hypothete/shiny-machine/example_secrets.h

// SECRET - do not share

#define SECRET_SSID  "your-ssid"
#define SECRET_PASSWORD "your-password"
#define SECRET_TWILIO_URL "your-url-from-twilio"
#define SECRET_TWILIO_AUTH "your-base64-auth"
#define SECRET_TWILIO_POST_BODY "To=+yournumber&From=+yourtwilionumber&Body="
