hypothete/shiny-machine/(commit log)

2019-07-25 switched lux sensors
2019-07-26 cut down on duty cycle again and added refresh to webpage
2019-08-30 editing and added board image
2019-08-30 Added enclosure pic
2019-08-30 switched video order
2019-09-05 updated flowchart with new lux threshold
